steliosv/EASy/Station_software/Source Code EASY/easy-common/Documentation/imgs/delayedstalta.png

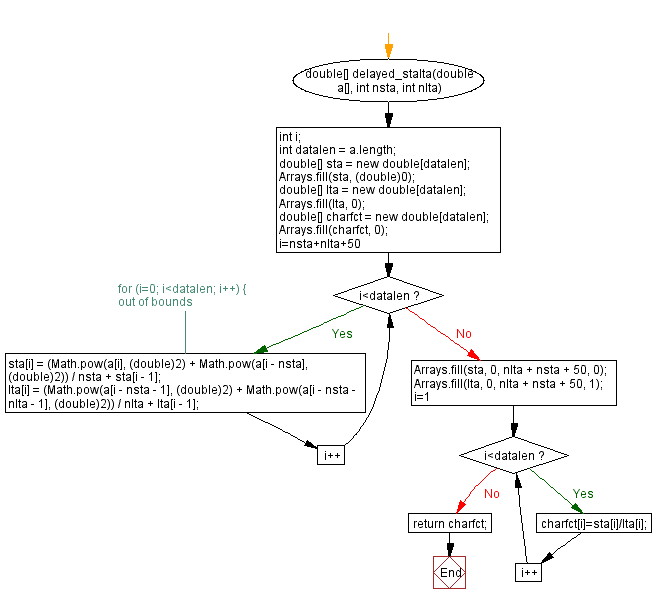
Station_software/Source Code EASY/easy-common/Documentation/imgs/delayedstalta.png
