steliosv/EASy/Station_software/Source Code EASY/easy-common/Documentation/imgs/recursive_stalta.png

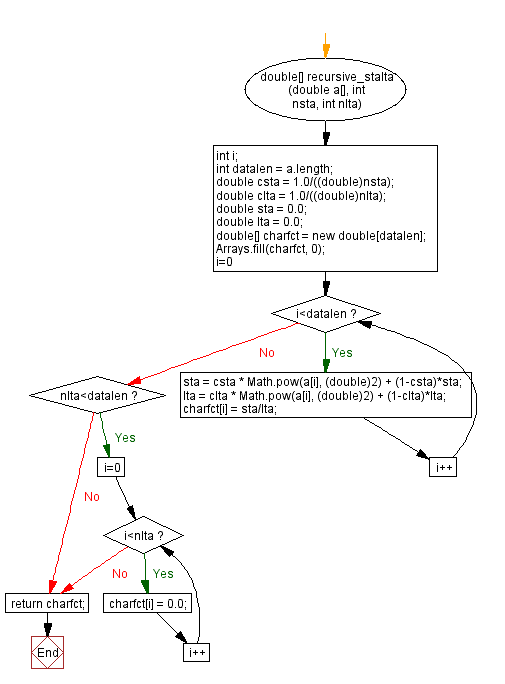
Station_software/Source Code EASY/easy-common/Documentation/imgs/recursive_stalta.png
