steliosv/EASy/Station_software/Source Code EASY/easy-common/Documentation/imgs/tcpdalg.png

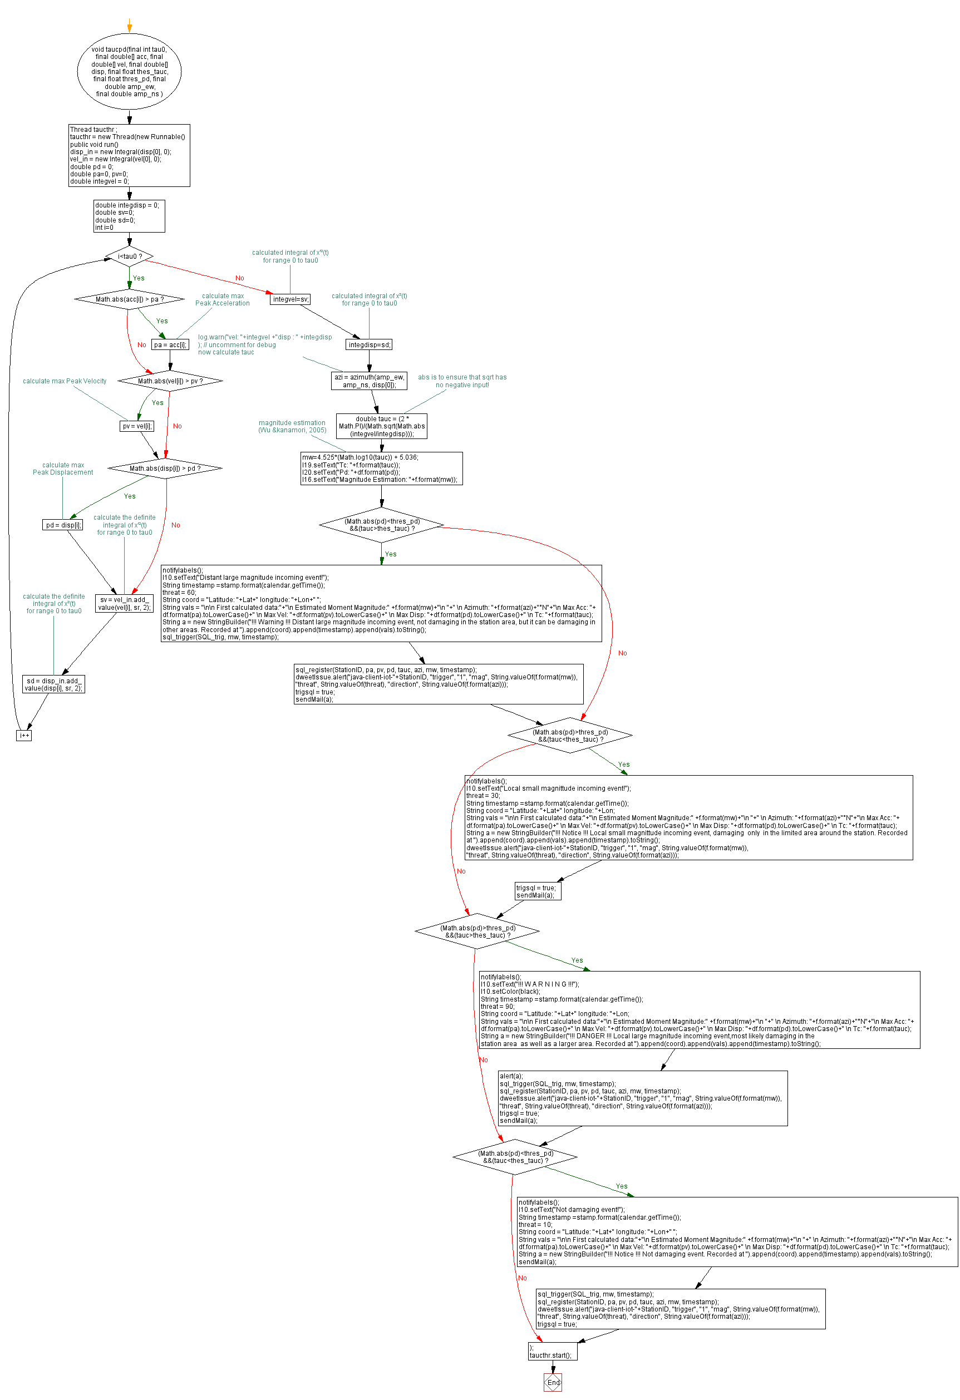
Station_software/Source Code EASY/easy-common/Documentation/imgs/tcpdalg.png
