steliosv/EASy/Station_software/Source Code EASY/easy-common/Documentation/imgs/zdetect2.png

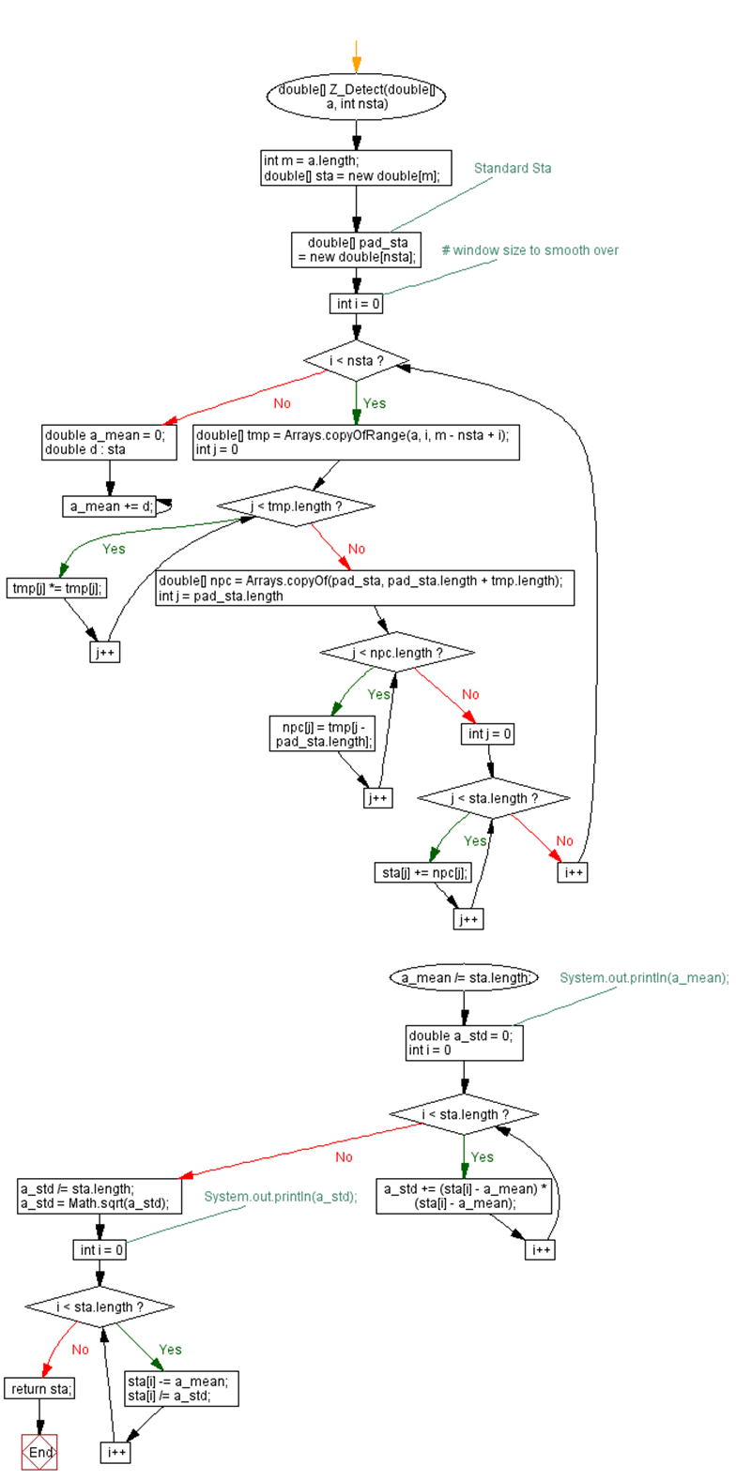
Station_software/Source Code EASY/easy-common/Documentation/imgs/zdetect2.png
