steliosv/EASy/Station_software/Source Code EASY/easy-common/Documentation/imgs/zdetect.png

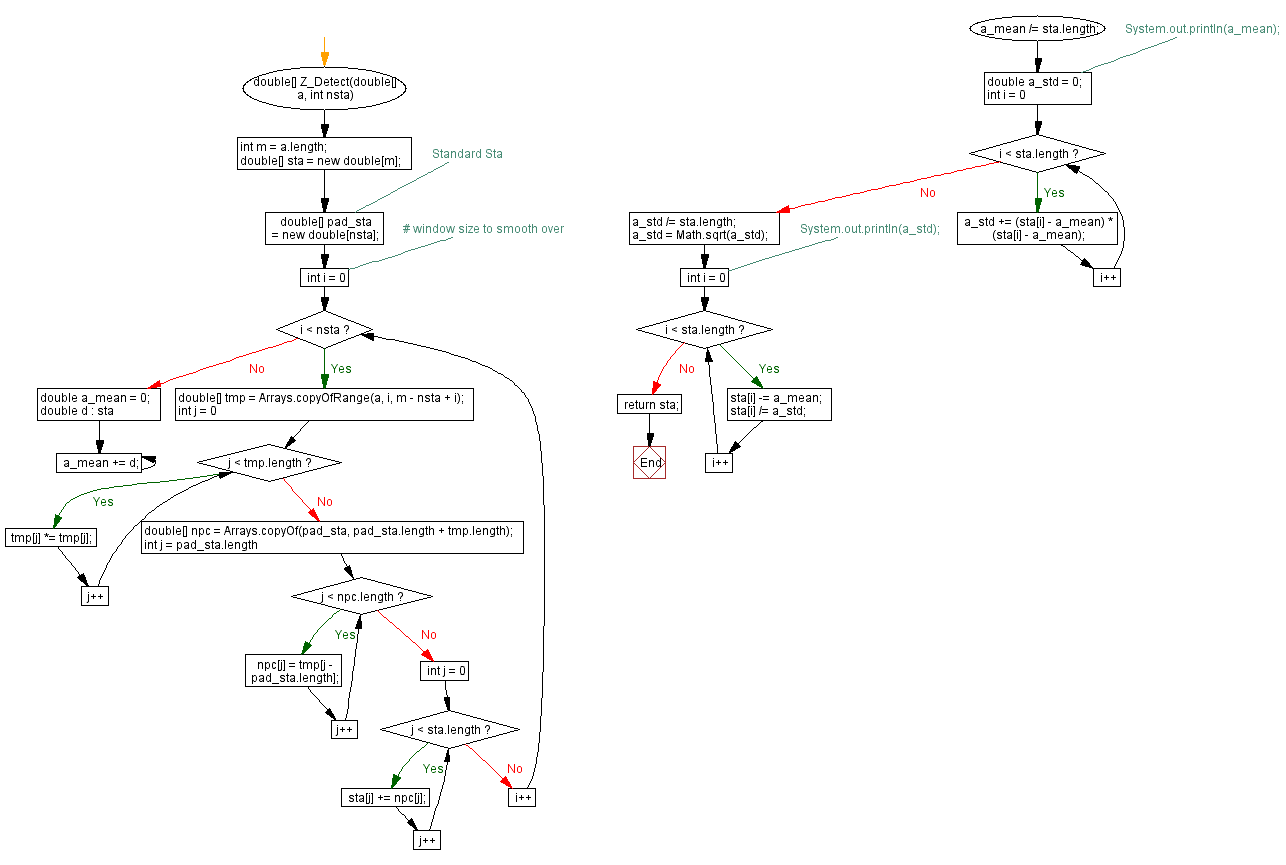
Station_software/Source Code EASY/easy-common/Documentation/imgs/zdetect.png
