steliosv/EASy/hardware/ribbon_conn_pcbs/geopreamp-selgain +-9v w buff/3-channel_geo_amplifier.brd

## EAGLE design hardware/ribbon_conn_pcbs/geopreamp-selgain +-9v w buff/3-channel_geo_amplifier.brd (2020-01-28)

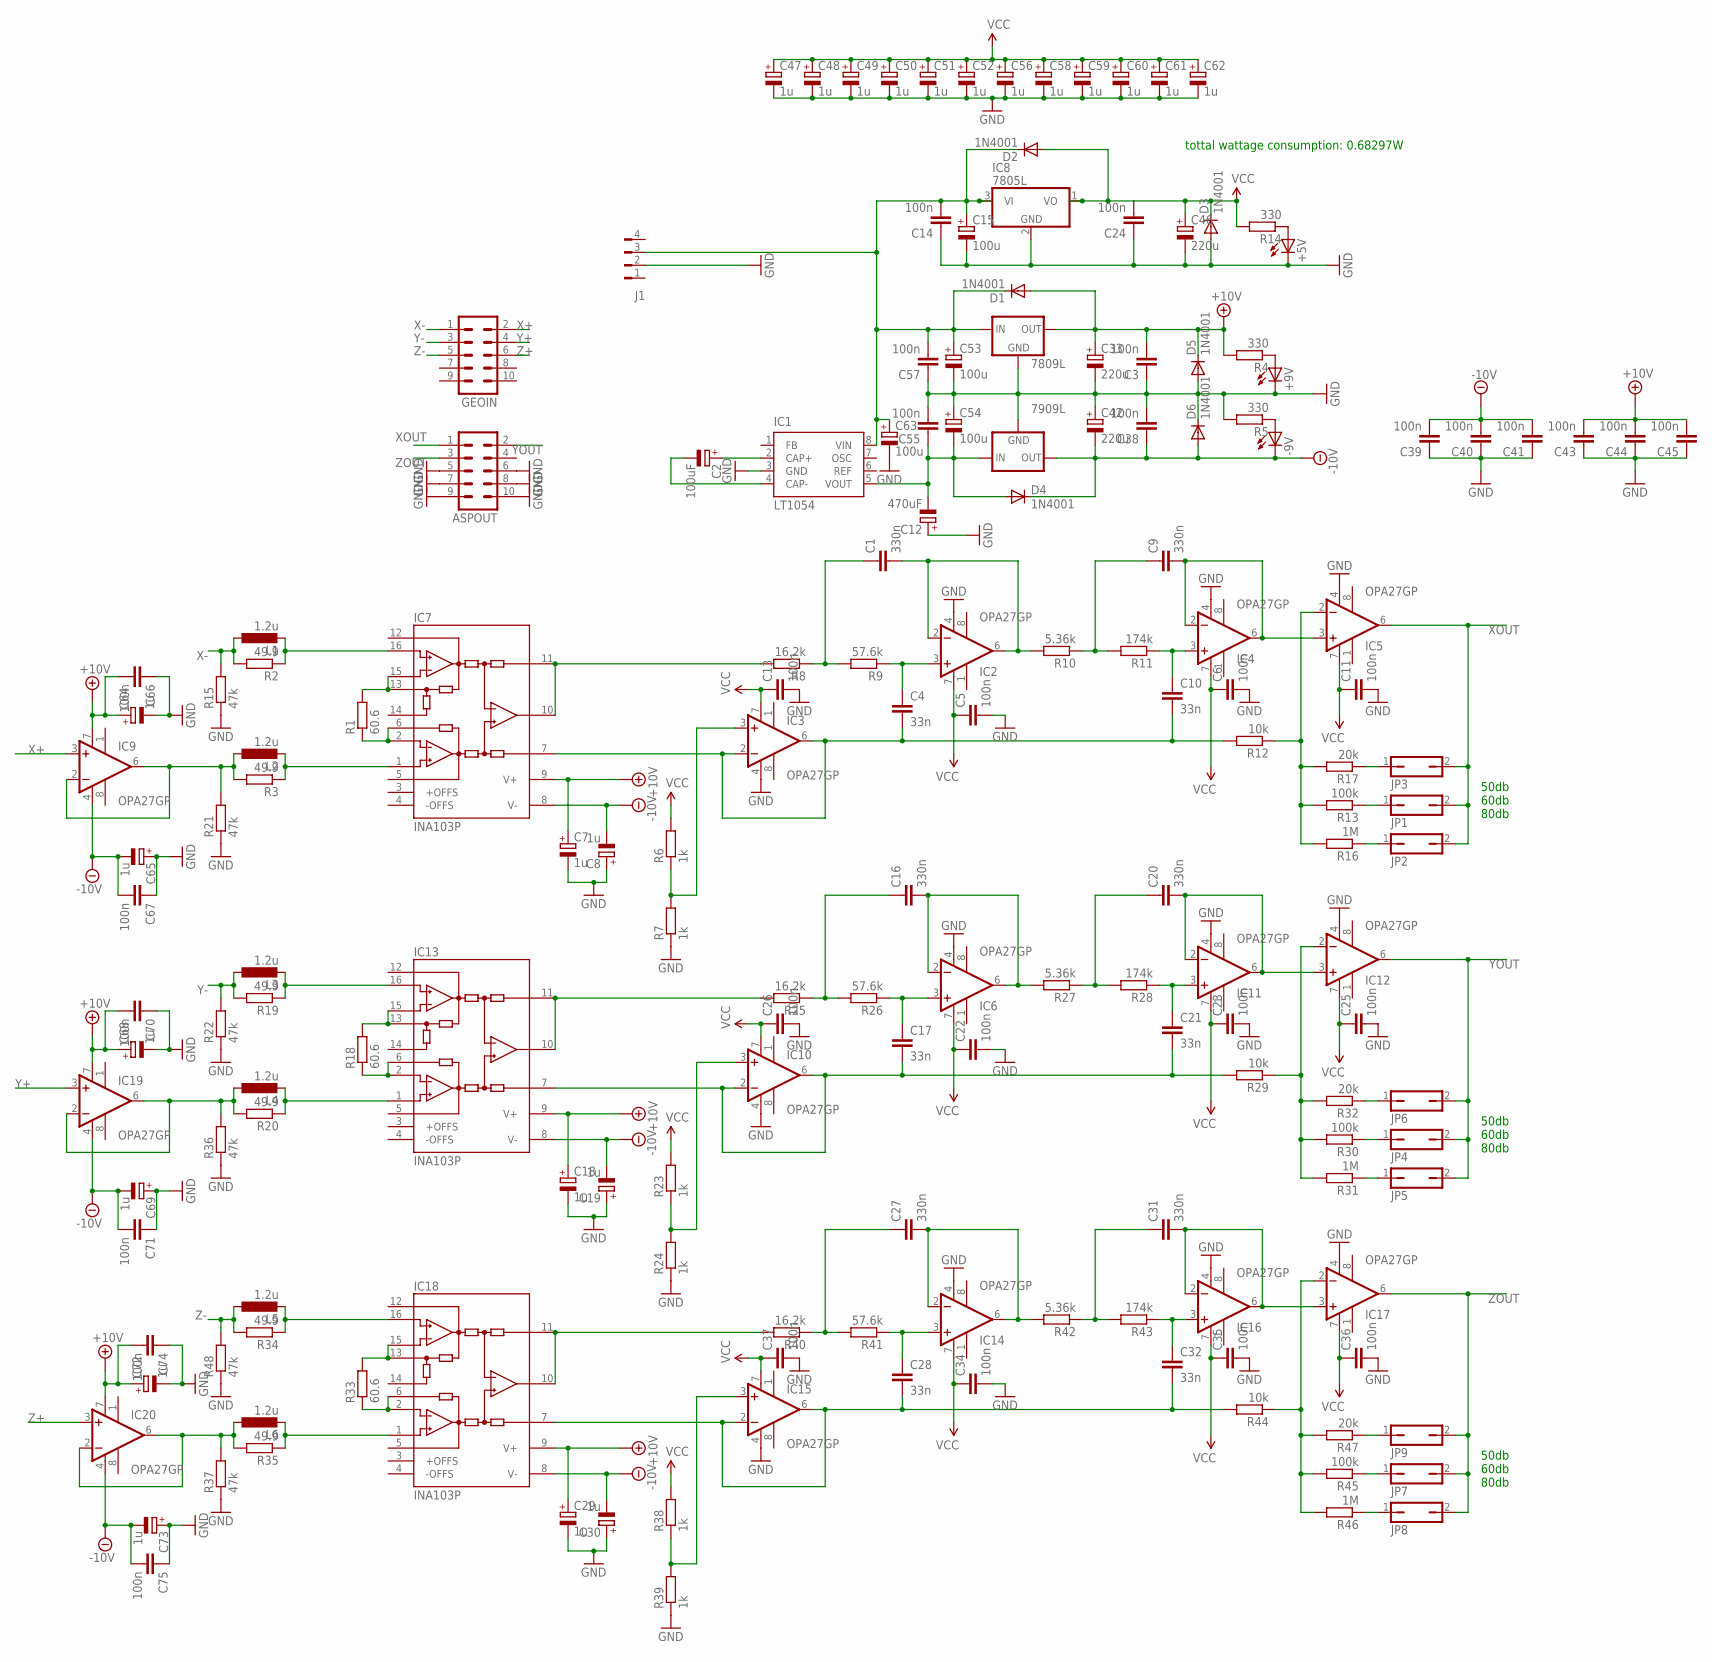
[picture p7: schematic 3-channel_geo_amplifier.sch]

Parts:
7809L: 78LXX
7909L: 79LXX
+5V, +9V: LED3MM
-9V: LED3MM
ASPOUT: ML10
C1, C9, C16, C20, C27, C31: 330n; C050-025X075
C2: 100uF; E2,5-7
C3, C5, C6, C11, C13, C14, C22, C23, C24, C25, C26, C34, C35, C36, C37, C38, C39, C40, C41, C43, C44, C45, C55, C57, C66, C67, C70, C71, C74, C75: 100n; C050-025X075
C4, C10, C17, C21, C28, C32: 33n; C050-025X075
C7, C8, C18, C19, C29, C30, C47, C48, C49, C50, C51, C52, C56, C58, C59, C60, C61, C62, C64, C65, C68, C69, C72, C73: 1u; B45181A
C12: 470uF; E5-8,5
C15: 100u; E2,5-7
C33, C42: 220u; E2,5-5
C46: 220u; E2,5-7
C53, C54, C63: 100u; E2,5-5
D1, D2, D3, D4, D5, D6: 1N4001; DO41-10
GEOIN: ML10
IC1: LT1054; DIL8
IC2, IC3, IC4, IC5, IC6, IC9, IC10, IC11, IC12, IC14, IC15, IC16, IC17, IC19, IC20: OPA27GP; DIL08
IC7, IC13, IC18: INA103P; DIL16
IC8: 7805L; TO92
J1: FLOP-4W827001; 827001
JP1, JP2, JP3, JP4, JP5, JP6, JP7, JP8, JP9: JP1Q; JP1
L1, L2, L3, L4, L5, L6: 1.2u; 0207/10
R1, R18, R33: 60.6; 0207/10
R2, R3, R19, R20, R34, R35: 49.9; 0207/10
R4, R5, R14: 330; 0207/10
R6, R7, R23, R24, R38, R39: 1k; 0207/10
R8, R25, R40: 16.2k; 0207/10
R9, R26, R41: 57.6k; 0207/10
R10, R27, R42: 5.36k; 0207/10
R11, R28, R43: 174k; 0207/10
R12, R29, R44: 10k; 0207/10
R13, R30, R45: 100k; 0207/10
R15, R21, R22, R36, R37, R48: 47k; 0207/10
R16, R31, R46: 1M; 0207/10
R17, R32, R47: 20k; 0207/10

Connections:
+10V: 7809L.OUT, C3.2, C7.+, C18.+, C29.+, C33.+, C43.2, C44.2, C45.2, C64.+, C66.2, C68.+, C70.2, C72.+, C74.2, D1.A, D5.C, IC7.9 (V+), IC9.7 (V+), IC13.9 (V+), IC18.9 (V+), IC19.7 (V+), IC20.7 (V+), R4.2
-10V: 7909L.OUT, -9V.K (C), C8.-, C19.-, C30.-, C38.1, C39.2, C40.2, C41.2, C42.-, C65.-, C67.2, C69.-, C71.2, C73.-, C75.2, D4.C, D6.A, IC7.8 (V-), IC9.4 (V-), IC13.8 (V-), IC18.8 (V-), IC19.4 (V-), IC20.4 (V-)
A: IC20.2 (-IN), IC20.6 (OUT), L6.1, R35.2, R37.2
GND: 7809L.GND, 7909L.GND, +5V.K (C), +9V.K (C), ASPOUT.5, ASPOUT.6, ASPOUT.7, ASPOUT.8, ASPOUT.9, ASPOUT.10, C3.1, C5.2, C6.2, C7.-, C8.+, C11.2, C12.+, C13.2, C14.1, C15.-, C18.-, C19.+, C22.2, C23.2, C24.1, C25.2, C26.2, C29.-, C30.+, C33.-, C34.2, C35.2, C36.2, C37.2, C38.2, C39.1, C40.1, C41.1, C42.+, C43.1, C44.1, C45.1, C46.-, C47.-, C48.-, C49.-, C50.-, C51.-, C52.-, C53.-, C54.+, C55.2, C56.-, C57.1, C58.-, C59.-, C60.-, C61.-, C62.-, C63.-, C64.-, C65.+, C66.1, C67.1, C68.-, C69.+, C70.1, C71.1, C72.-, C73.+, C74.1, C75.1, D3.A, D5.A, D6.C, IC1.3 (GND), IC2.4 (V-), IC3.4 (V-), IC4.4 (V-), IC5.4 (V-), IC6.4 (V-), IC8.2 (GND), IC10.4 (V-), IC11.4 (V-), IC12.4 (V-), IC14.4 (V-), IC15.4 (V-), IC16.4 (V-), IC17.4 (V-), J1.2, R5.2, R7.1, R15.1, R21.1, R22.1, R24.1, R36.1, R37.1, R39.1, R48.1
unnamed: IC7.13 (-RG), IC7.15 (-GS), R1.2
unnamed: IC7.2 (+GS), IC7.6 (+RG), R1.1
unnamed: IC7.1 (+IN), L2.2, R3.1
unnamed: IC19.2 (-IN), IC19.6 (OUT), L4.1, R20.2, R36.2
unnamed: IC7.16 (-IN), L1.2, R2.1
unnamed: C4.2, C10.2, IC3.2 (-IN), IC3.6 (OUT), IC7.7 (REF), R12.2
unnamed: IC3.3 (+IN), R6.1, R7.2
unnamed: IC7.10 (OUT), IC7.11 (SENSE), R8.2
unnamed: C1.1, R8.1, R9.2
unnamed: C4.1, IC2.3 (+IN), R9.1
unnamed: C1.2, IC2.2 (-IN), IC2.6 (OUT), R10.2
unnamed: C9.2, IC4.2 (-IN), IC4.6 (OUT), IC5.3 (+IN)
unnamed: C9.1, R10.1, R11.2
unnamed: C10.1, IC4.3 (+IN), R11.1
unnamed: +5V.A, R14.1
unnamed: IC5.2 (-IN), R12.1, R13.2, R16.2, R17.2
unnamed: JP1.1, R13.1
unnamed: IC9.2 (-IN), IC9.6 (OUT), L2.1, R3.2, R21.2
unnamed: +9V.A, R4.1
unnamed: IC13.13 (-RG), IC13.15 (-GS), R18.2
unnamed: JP2.1, R16.1
unnamed: IC13.2 (+GS), IC13.6 (+RG), R18.1
unnamed: JP3.1, R17.1
unnamed: IC13.1 (+IN), L4.2, R20.1
unnamed: C2.-, IC1.4 (CAP-)
unnamed: C2.+, IC1.2 (CAP+)
unnamed: IC13.16 (-IN), L3.2, R19.1
unnamed: C17.2, C21.2, IC10.2 (-IN), IC10.6 (OUT), IC13.7 (REF), R29.2
unnamed: IC10.3 (+IN), R23.1, R24.2
unnamed: IC13.10 (OUT), IC13.11 (SENSE), R25.2
unnamed: C16.1, R25.1, R26.2
unnamed: C17.1, IC6.3 (+IN), R26.1
unnamed: C16.2, IC6.2 (-IN), IC6.6 (OUT), R27.2
unnamed: C20.1, R27.1, R28.2
unnamed: C21.1, IC11.3 (+IN), R28.1
unnamed: C20.2, IC11.2 (-IN), IC11.6 (OUT), IC12.3 (+IN)
unnamed: IC12.2 (-IN), R29.1, R30.2, R31.2, R32.2
unnamed: -9V.A, R5.1
unnamed: JP4.1, R30.1
unnamed: JP5.1, R31.1
unnamed: JP6.1, R32.1
unnamed: IC18.13 (-RG), IC18.15 (-GS), R33.2
unnamed: IC18.2 (+GS), IC18.6 (+RG), R33.1
unnamed: IC18.1 (+IN), L6.2, R35.1
unnamed: 7809L.IN, C14.2, C15.+, C53.+, C57.2, C63.+, D1.C, D2.C, IC1.8 (VIN), IC8.3 (VI), J1.3
unnamed: IC18.16 (-IN), L5.2, R34.1
unnamed: C28.2, C32.2, IC15.2 (-IN), IC15.6 (OUT), IC18.7 (REF), R44.2
unnamed: IC15.3 (+IN), R38.1, R39.2
unnamed: IC18.10 (OUT), IC18.11 (SENSE), R40.2
unnamed: C27.1, R40.1, R41.2
unnamed: C28.1, IC14.3 (+IN), R41.1
unnamed: 7909L.IN, C12.-, C54.-, C55.1, D4.A, IC1.5 (VOUT)
unnamed: C27.2, IC14.2 (-IN), IC14.6 (OUT), R42.2
unnamed: C31.1, R42.1, R43.2
unnamed: C32.1, IC16.3 (+IN), R43.1
unnamed: C31.2, IC16.2 (-IN), IC16.6 (OUT), IC17.3 (+IN)
unnamed: IC17.2 (-IN), R44.1, R45.2, R46.2, R47.2
unnamed: JP7.1, R45.1
unnamed: JP8.1, R46.1
unnamed: JP9.1, R47.1
VCC: C5.1, C6.1, C11.1, C13.1, C22.1, C23.1, C24.2, C25.1, C26.1, C34.1, C35.1, C36.1, C37.1, C46.+, C47.+, C48.+, C49.+, C50.+, C51.+, C52.+, C56.+, C58.+, C59.+, C60.+, C61.+, C62.+, D2.A, D3.C, IC2.7 (V+), IC3.7 (V+), IC4.7 (V+), IC5.7 (V+), IC6.7 (V+), IC8.1 (VO), IC10.7 (V+), IC11.7 (V+), IC12.7 (V+), IC14.7 (V+), IC15.7 (V+), IC16.7 (V+), IC17.7 (V+), R6.2, R14.2, R23.2, R38.2
X+: GEOIN.2, IC9.3 (+IN)
X-: GEOIN.1, L1.1, R2.2, R15.2
XOUT: ASPOUT.1, IC5.6 (OUT), JP1.2, JP2.2, JP3.2
Y+: GEOIN.4, IC19.3 (+IN)
Y-: GEOIN.3, L3.1, R19.2, R22.2
YOUT: ASPOUT.2, IC12.6 (OUT), JP4.2, JP5.2, JP6.2
Z+: GEOIN.6, IC20.3 (+IN)
Z-: GEOIN.5, L5.1, R34.2, R48.2
ZOUT: ASPOUT.3, IC17.6 (OUT), JP7.2, JP8.2, JP9.2

Notes on the sheet:
50db 60db 80db
tottal wattage consumption: 0.68297W

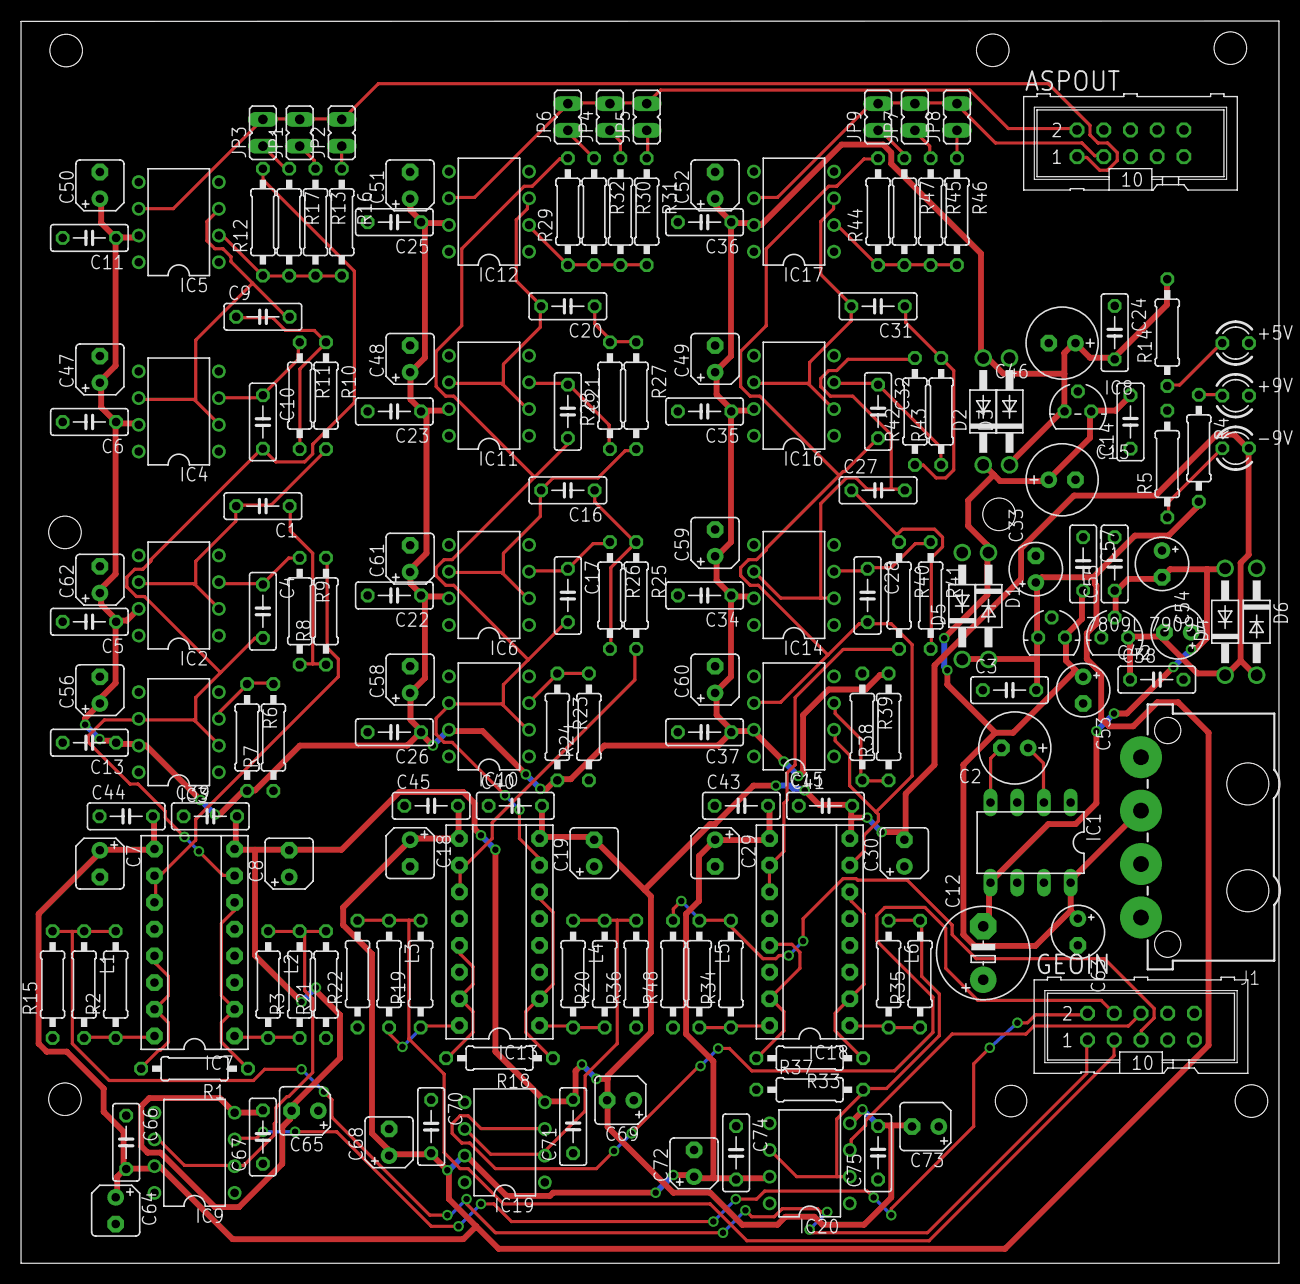
[picture p8: board 3-channel_geo_amplifier.brd from above]

Board: 2 copper layers, 119.6 x 118.1 mm, 172 parts (0 on the bottom side), 74 nets.
