steliosv/EASy/hardware/ribbon_conn_pcbs/acc_sen_new/connectors.brd

## EAGLE design hardware/ribbon_conn_pcbs/acc_sen_new/connectors.brd (2020-01-28)

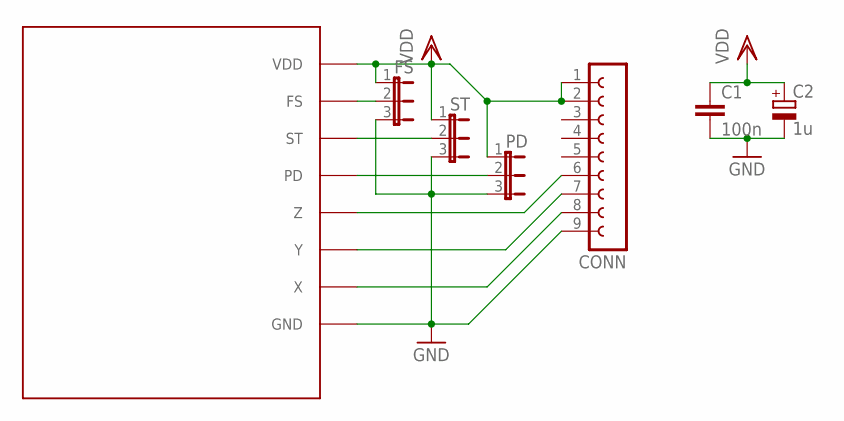
[picture p9: schematic connectors.sch]

Parts:
C1: 100n; C050-025X075
C2: 1u; E2-5
CONN: FE09-1; FE09
FS: JP2E; JP2
PD: JP2E; JP2
ST: JP2E; JP2
U$2: LIS; LIS344

Connections:
GND: C1.2, C2.-, CONN.9, FS.3, PD.3, ST.3, U$2.GND1 (GND), U$2.GND2 (GND), U$2.GND3 (GND), U$2.GND5 (GND)
unnamed: CONN.8, U$2.X
unnamed: FS.2, U$2.FS
unnamed: CONN.7, U$2.Y
unnamed: CONN.6, U$2.Z
unnamed: ST.2, U$2.ST
unnamed: PD.2, U$2.PD
VDD: C1.1, C2.+, CONN.1, CONN.2, FS.1, PD.1, ST.1, U$2.VDD, U$2.VDD2 (VDD)

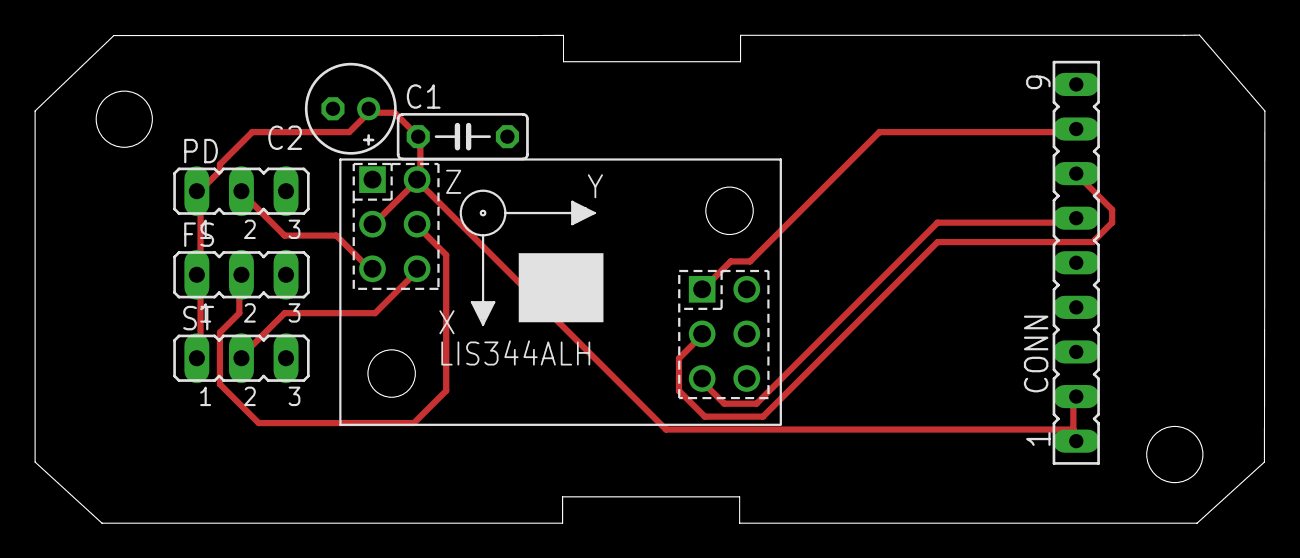
[picture p10: board connectors.brd from above]

Board: 2 copper layers, 70.1 x 27.8 mm, 7 parts (0 on the bottom side), 8 nets.
