steliosv/EASy/hardware/ribbon_conn_pcbs/ads1256_adapter stellaris msp432/adapter.brd

## EAGLE design hardware/ribbon_conn_pcbs/ads1256_adapter stellaris msp432/adapter.brd (2020-01-28)

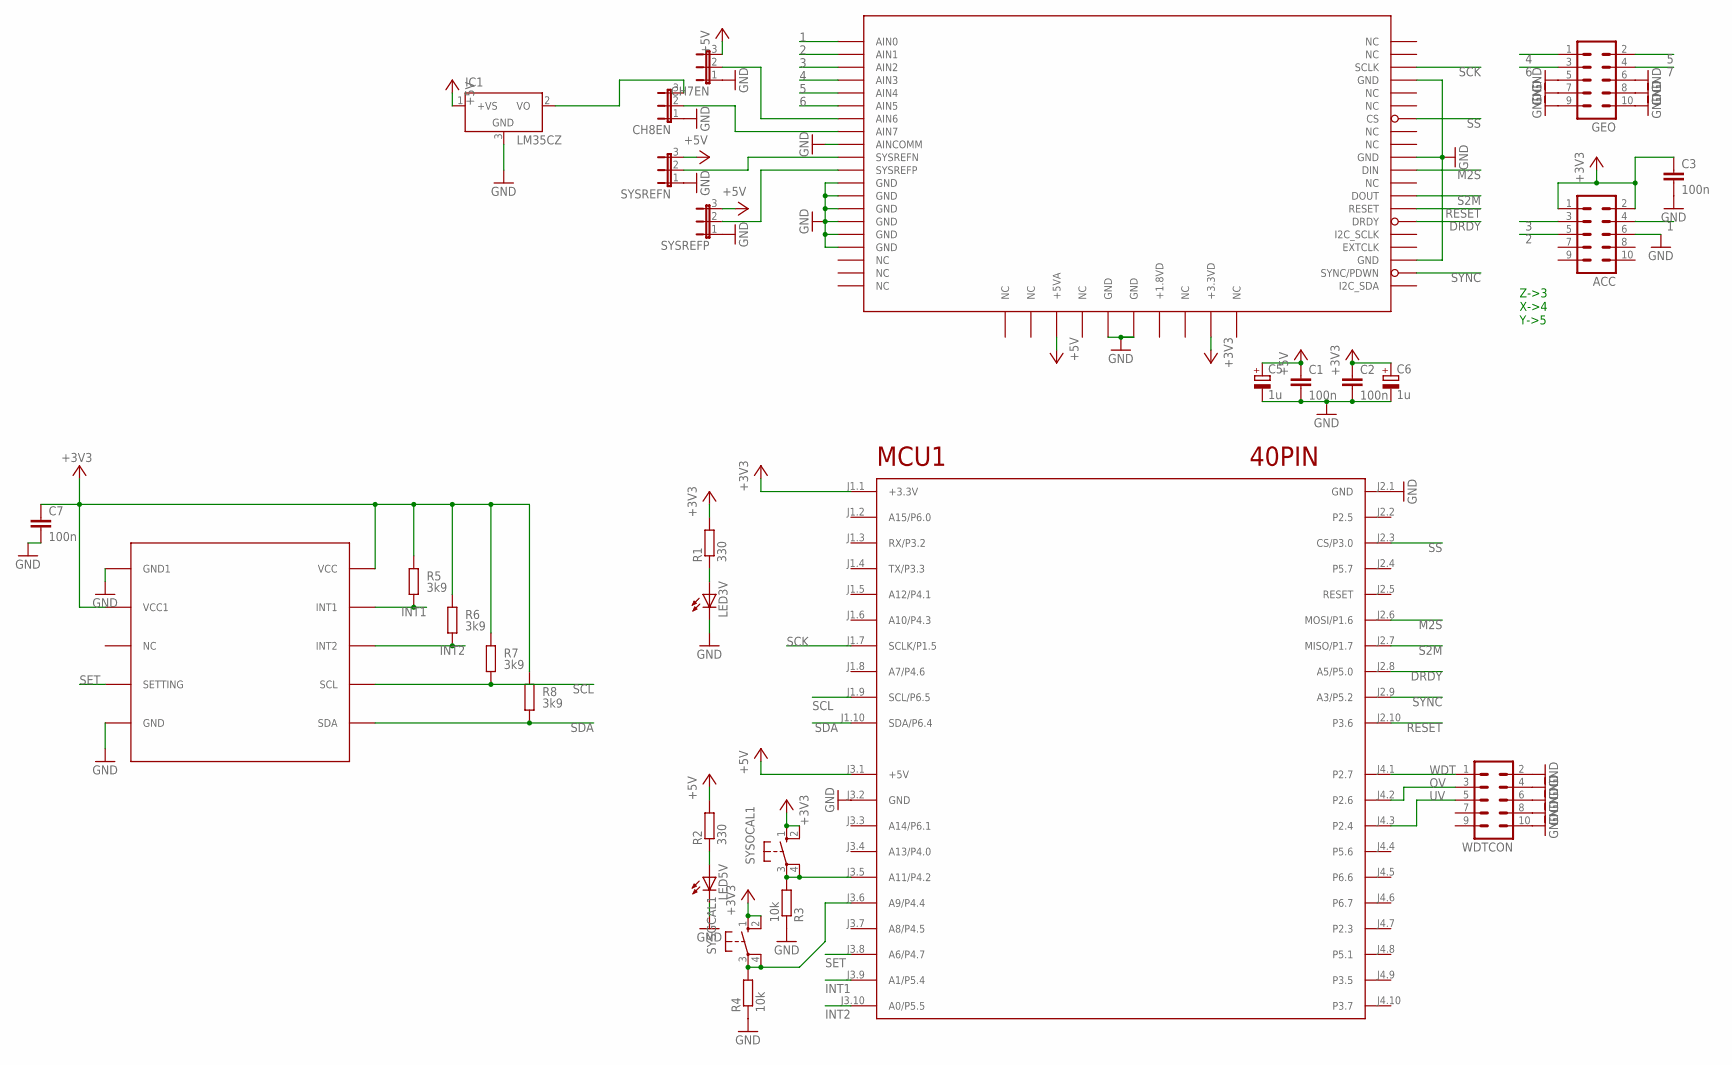
[picture p11: schematic adapter.sch]

Parts:
ACC: ML10
C1, C2, C3, C7: 100n; C050-025X075
C5, C6: 1u; E2,5-6E
CH7EN, CH8EN: JP2E; JP2
GEO: ML10
IC1: LM35CZ; TO92
LED3V, LED5V: LED3MM
MCU1: 40PIN
R1, R2: 330; 0207/10
R3, R4: 10k; 0207/10
R5, R6, R7, R8: 3k9; 0207/10; TOLERANCE 5%
SYSGCAL1: 10-XX; B3F-10XX
SYSOCAL1: 10-XX; B3F-10XX
SYSREFN: JP2E; JP2
SYSREFP: JP2E; JP2
U$1: D7S
U$2: ADS1256EVM
WDTCON: ML10

Connections:
1: ACC.4, U$2.J1.1 (AIN0)
2: ACC.5, U$2.J1.2 (AIN1)
3: ACC.3, U$2.J1.3 (AIN2)
4: GEO.1, U$2.J1.4 (AIN3)
5: GEO.2, U$2.J1.5 (AIN4)
6: GEO.3, U$2.J1.6 (AIN5)
7: GEO.4
+3V3: ACC.1, ACC.2, C2.1, C3.1, C6.+, C7.1, MCU1.J1.1 (+3.3V), R1.2, R5.2, R6.2, R7.2, R8.2, SYSGCAL1.1 (S), SYSGCAL1.2 (S1), SYSOCAL1.1 (S), SYSOCAL1.2 (S1), U$1.P$1 (VCC), U$1.P$9 (VCC1), U$2.J3.9 (+3.3VD)
+5V: C1.1, C5.+, CH7EN.3, IC1.1 (+VS), MCU1.J3.1 (+5V), R2.2, SYSREFN.3, SYSREFP.3, U$2.J3.3 (+5VA)
DRDY: MCU1.J2.8 (A5/P5.0), U$2.J2.15 (DRDY)
GND: ACC.6, C1.2, C2.2, C3.2, C5.-, C6.-, C7.2, CH7EN.1, CH8EN.1, GEO.5, GEO.6, GEO.7, GEO.8, GEO.9, GEO.10, IC1.3 (GND), LED3V.K (C), LED5V.K (C), MCU1.J2.1 (GND), MCU1.J3.2 (GND), R3.1, R4.1, SYSREFN.1, SYSREFP.1, U$1.P$6 (GND), U$1.P$10 (GND1), U$2.J1.9 (GND), U$2.J1.10 (AINCOMM), U$2.J1.11 (GND), U$2.J1.13 (GND), U$2.J1.15 (GND), U$2.J1.17 (GND), U$2.J1.19 (GND), U$2.J2.4 (GND), U$2.J2.10 (GND), U$2.J2.18 (GND), U$2.J3.5 (GND), U$2.J3.6 (GND), WDTCON.2, WDTCON.4, WDTCON.6, WDTCON.8, WDTCON.10
INT1: MCU1.J3.9 (A1/P5.4), R5.1, U$1.P$2 (INT1)
INT2: MCU1.J3.10 (A0/P5.5), R6.1, U$1.P$3 (INT2)
M2S: MCU1.J2.6 (MOSI/P1.6), U$2.J2.11 (DIN)
unnamed: LED3V.A, R1.1
unnamed: LED5V.A, R2.1
unnamed: CH8EN.3, IC1.2 (VO)
unnamed: CH8EN.2, U$2.J1.8 (AIN7)
unnamed: CH7EN.2, U$2.J1.7 (AIN6)
unnamed: MCU1.J3.5 (A11/P4.2), R3.2, SYSOCAL1.3, SYSOCAL1.4 (P1)
unnamed: MCU1.J3.6 (A9/P4.4), R4.2, SYSGCAL1.3, SYSGCAL1.4 (P1)
unnamed: SYSREFN.2, U$2.J1.18 (SYSREFN)
unnamed: SYSREFP.2, U$2.J1.20 (SYSREFP)
OV: MCU1.J4.2 (P2.6), WDTCON.3
RESET: MCU1.J2.10 (P3.6), U$2.J2.14 (RESET)
S2M: MCU1.J2.7 (MISO/P1.7), U$2.J2.13 (DOUT)
SCK: MCU1.J1.7 (SCLK/P1.5), U$2.J2.3 (SCLK)
SCL: MCU1.J1.9 (SCL/P6.5), R7.1, U$1.P$4 (SCL)
SDA: MCU1.J1.10 (SDA/P6.4), R8.1, U$1.P$5 (SDA)
SET: MCU1.J3.8 (A6/P4.7), U$1.P$7 (SETTING)
SS: MCU1.J2.3 (CS/P3.0), U$2.J2.7 (CS)
SYNC: MCU1.J2.9 (A3/P5.2), U$2.J2.19 (SYNC/PDWN)
UV: MCU1.J4.3 (P2.4), WDTCON.5
WDT: MCU1.J4.1 (P2.7), WDTCON.1

Notes on the sheet:
Z->3 X->4 Y->5

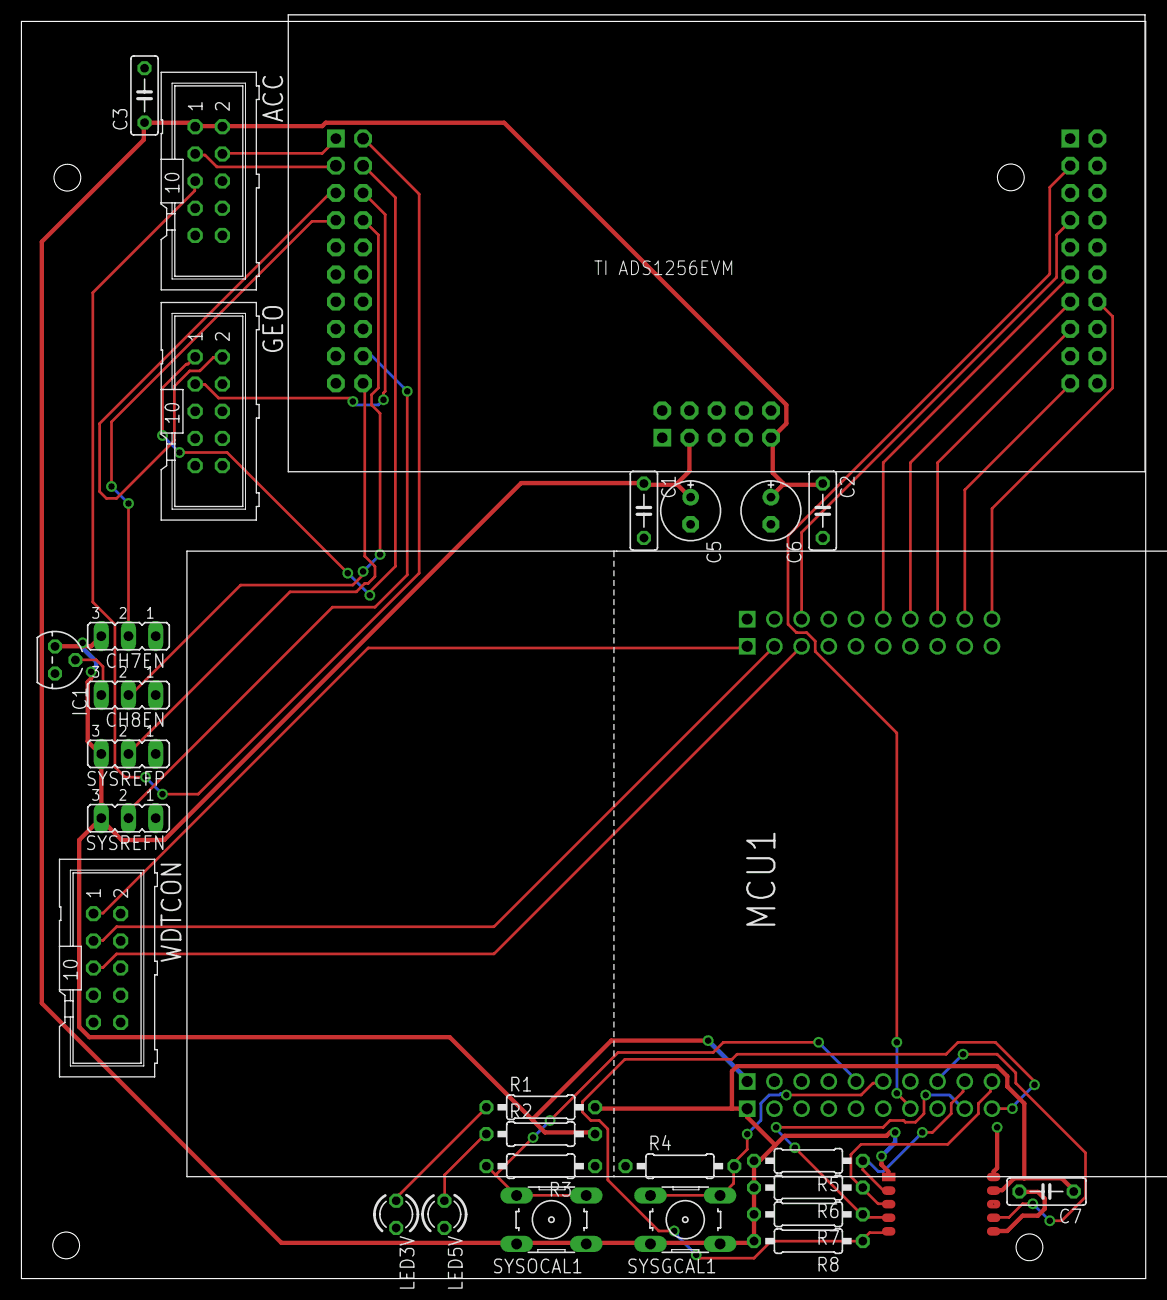
[picture p12: board adapter.brd from above]

Board: 2 copper layers, 105.0 x 117.4 mm, 29 parts (0 on the bottom side), 33 nets.
