steliosv/EASy/hardware/ribbon_conn_pcbs/max697 with UC3903 supervisory system/wdt.brd

## EAGLE design hardware/ribbon_conn_pcbs/max697 with UC3903 supervisory system/wdt.brd (2020-01-28)

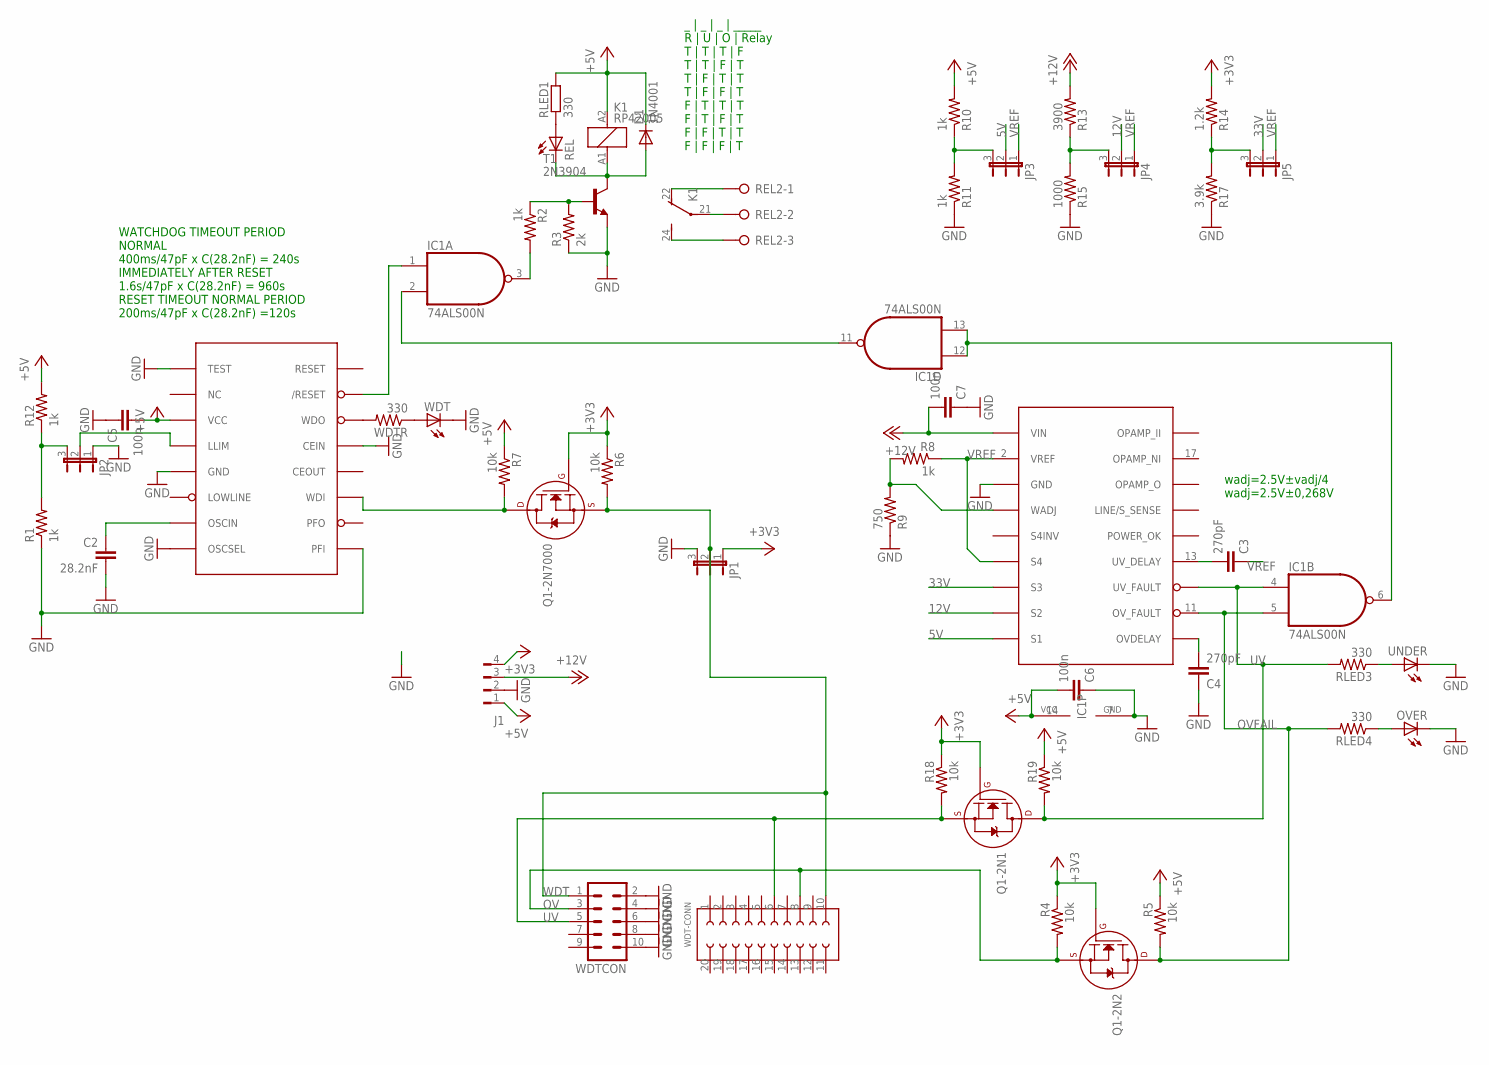
[picture p13: schematic wdt.sch]

Parts:
C2: 28.2nF; C050-025X075
C3, C4: 270pF; C050-025X075
C5, C6, C7: 100n; C050-025X075
D1: 1N4001; DO41-10
IC1: 74ALS00N; DIL14
J1: FLOP-4W827001; 827001
JP1, JP2, JP3, JP4, JP5: JP2E; JP2
K1: RP42005; RP420
OVER: LED3MM
Q1-2N1, Q1-2N2, Q1-2N7000: 2N7000_TO92; TO-92
R1, R2, R8, R10, R11, R12: 1k; 0207/10
R3: 2k; 0207/10
R4, R5, R6, R7, R18, R19: 10k; 0207/10
R9: 750; 0207/10
R13: 3900; 0207/10
R14: 1.2k; 0207/10
R15: 1000; 0207/10
R17: 3.9k; 0207/10
REL: LED3MM
REL2: W237-3E
RLED1, RLED3, RLED4: 330; 0207/10
T1: 2N3904; TO92
U$1: UC3903; DIL18
U$2: MAX697; DIL16
UNDER: LED3MM
WDT: LED3MM
WDT-CONN: 623X2021021
WDTCON: ML10
WDTR: 330; 0207/10

Connections:
5V: JP3.2, U$1.9 (S1)
12V: JP4.2, U$1.8 (S2)
33V: JP5.2, U$1.7 (S3)
+3V3: J1.4, JP1.1, Q1-2N1.2 (G), Q1-2N2.2 (G), Q1-2N7000.2 (G), R4.1, R6.1, R14.2, R18.1
+5V: C5.2, C6.2, D1.C, IC1.14 (VCC), J1.1, K1.A2 (1), R5.1, R7.1, R10.2, R12.2, R19.1, RLED1.2, U$2.3 (VCC)
+12V: C7.2, J1.3, R13.2, U$1.1 (VIN)
GND: C2.2, C4.1, C5.1, C6.1, C7.1, IC1.7 (GND), J1.2, JP1.3, JP2.1, OVER.K (C), R1.1, R3.1, R9.1, R11.1, R15.1, R17.1, T1.3 (E), U$1.3 (GND), U$2.1 (TEST), U$2.5 (GND), U$2.8 (OSCSEL), U$2.9 (PFI), U$2.13 (CEIN), UNDER.K (C), WDT.K (C), WDTCON.2, WDTCON.4, WDTCON.6, WDTCON.8, WDTCON.10
unnamed: Q1-2N7000.3 (D), R7.2, U$2.11 (WDI)
unnamed: D1.A, K1.A1 (2), REL.K (C), T1.1 (C)
unnamed: IC1.1 (I0), U$2.15 (/RESET)
unnamed: JP5.3, R14.1, R17.2
unnamed: JP2.2, U$2.4 (LLIM)
unnamed: JP3.3, R10.1, R11.2
unnamed: U$2.14 (WDO), WDTR.2
unnamed: IC1.3 (O), R2.2
unnamed: K1.22 (O), REL2.1
unnamed: R2.1, R3.2, T1.2 (B)
unnamed: REL.A, RLED1.1
unnamed: K1.21, REL2.2
unnamed: K1.24 (S), REL2.3
unnamed: R8.2, R9.2, U$1.4 (WADJ)
unnamed: JP4.3, R13.1, R15.2
unnamed: C3.2, U$1.13 (UV_DELAY)
unnamed: C4.2, U$1.10 (OVDELAY)
unnamed: IC1.2 (I1), IC1.11 (O)
unnamed: WDT.A, WDTR.1
unnamed: C2.1, U$2.7 (OSCIN)
unnamed: JP2.3, R1.2, R12.1
unnamed: IC1.6 (O), IC1.12 (I0), IC1.13 (I1)
unnamed: RLED3.1, UNDER.A
unnamed: OVER.A, RLED4.1
OV: Q1-2N2.1 (S), R4.2, WDT-CONN.8, WDTCON.3
OVFAIL: IC1.5 (I1), Q1-2N2.3 (D), R5.2, RLED4.2, U$1.11 (OV_FAULT)
UV: IC1.4 (I0), Q1-2N1.1 (S), Q1-2N1.3 (D), R18.2, R19.2, RLED3.2, U$1.12 (UV_FAULT), WDT-CONN.6, WDTCON.5
VREF: C3.1, JP3.1, JP4.1, JP5.1, R8.1, U$1.2 (VREF), U$1.6 (S4)
WDT: JP1.2, Q1-2N7000.1 (S), R6.2, WDT-CONN.10, WDTCON.1

Notes on the sheet:
wadj=2.5V±vadj/4 wadj=2.5V±0,268V
_ | _ | _ | _____ R | U | O | Relay T | T | T | F T | T | F | T T | F | T | T T | F | F | T F | T | T | T F | T | F | T F | F | T | T F | F | F | T
WATCHDOG TIMEOUT PERIOD NORMAL 400ms/47pF x C(28.2nF) = 240s IMMEDIATELY AFTER RESET 1.6s/47pF x C(28.2nF) = 960s RESET TIMEOUT NORMAL PERIOD 200ms/47pF x C(28.2nF) =120s

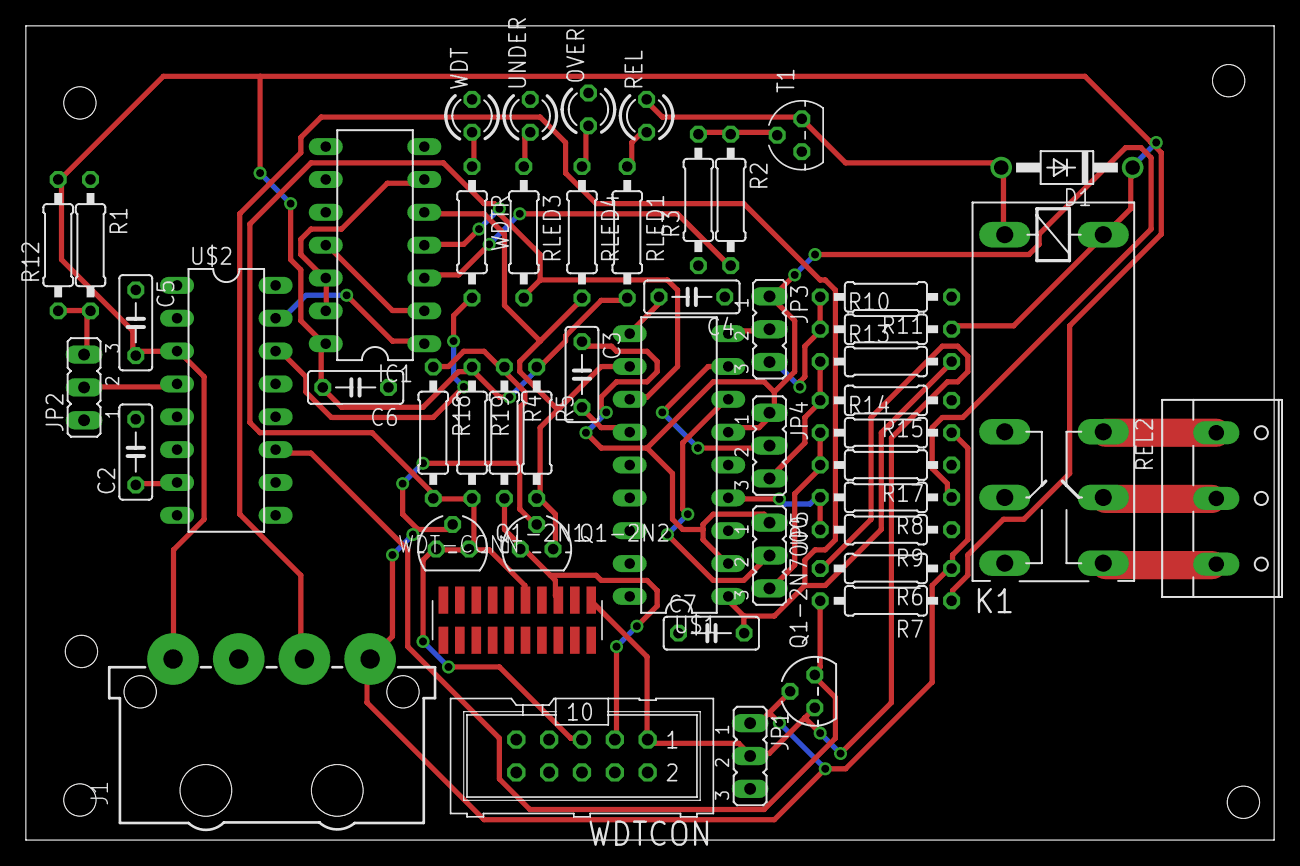
[picture p14: board wdt.brd from above]

Board: 2 copper layers, 96.5 x 63.0 mm, 50 parts (0 on the bottom side), 36 nets.
