steliosv/EASy/(notices)

Notices in the files:
parts and their libraries:
Wurth_Elektronik_Electromechanic_Board_t: Copyright: Würth Elektronik
